pfriedel/LifeClock/(commit log)

2012-10-06 Firmware release v1
    No logos, clock should automatically start, off-scale temperatures are
    rejected.
2012-11-05 Corrected summary of buffer scaling
    [LifeClock.ino]
2012-11-05 New sample: Particles / Qix
